the-Drunken-coder/n2-modular-hardpoint/project/analysis/improvements/README.md

# Improvement study runs

Summary: [docs/improvement-study.md](../../../docs/improvement-study.md). `results.csv` contains every case. `runs/<variant>/` contains `summary.json`, `geom.json` and the exact solver configs. These were generated by `tools/n2fea.py`. STEP and fields are not kept; rerun the tool to regenerate them.
