the-Drunken-coder/n2-modular-hardpoint/STATUS.md

# N2 status — R5

_Auto-generated by `site/build_status.py`; the selection is `project/active_design.json`._

**Current design:** R5, TowerPro MG92B positional servo, 3 printed parts in Bambu PAHT-CF. Receiver body: 72 × 53.5 × 20 mm. The complete retained envelope, including servo overhang, is specified in the [R5 package](project/designs/r5/README.md).

**Required loaded release:** 0.454 kg complete departing mass, 2 g total = **8.9044 N**. Complete-assembly retention proof target: **17.8089 N**. Extraction: -Z in R5 assembly coordinates.

**Evidence:** unqualified bench prototype. No assigned working-load rating, physical test result or flight qualification. Run the R5 CAD, mechanics, FEA and risk checks on this checkout; do not inherit old result numbers. See [evidence](docs/EVIDENCE_AND_READINESS.md).

**Next physical gate:** [R5 print inspection](docs/print-requirements.md), calibrated [servo interface](project/designs/r5/electronics/README.md), then the complete-assembly [R5 bench plan](docs/test-plan.md). Observe keeper clearance and actual departure separately.

P14 is a historical solenoid reference. Its committed STLs, controller tests and stress screens do not describe R5.

## Current sources

- [Requirements](docs/requirements.md)
- [R5 package and BOM](project/designs/r5/README.md)
- [CAD generator](project/designs/r5/cad/build.py)
- [Metadata](project/designs/r5/design.json)
