the-Drunken-coder/n2-modular-hardpoint/project/docs/review_notes.md

# P11 selection review record

## Decision implemented

N2 is the sole active development design. The CAD geometry and existing local controller function were preserved. The active documentation, BOM, print guidance, handoff and analysis subset now describe N2 alone.

## Review findings retained in the handoff

| Finding | Disposition |
|---|---|
| A selected design could be mistaken for a qualified or universally strongest attachment | Selection is recorded as the user's development choice. FEA numbers are raw model stress-threshold crossings, explicitly separate from proof/service load, breakage and loaded-release capacity. |
| Continuous rigid backing can overstate a real two-bolt installation's stiffness | The full-backing and ideal two-hole results remain distinct; aircraft backing and joints are open installation decisions. |
| The distal support exists in the CAD but has only 0.6 mm nominal retained overlap | Unloaded dimensional inspection and actual support engagement precede loaded tests. Ineffective-support results remain visible. |
| Support disappears before the adapter is unlocked | The 0.6 mm support-loss and 2.3 mm unlock positions are explicit. Full-stroke withdrawal demand and binding are priority measurements. |
| Historical manufacturing material notes could conflict with the user's PLA analysis choice | Active trial guidance and BOM use PLA, with the same 1.24 g/cm³ mass assumption as the analysis. Original CAD records remain frozen for provenance. |
| A nominal open position or animated departure could be mistaken for successful physical separation | The viewer's prescribed departure is illustrative. The design has no ejector or departure sensor; measured command, unlock and complete clearance are separate events. |
| Spring return or zero coil power could be mistaken for a fixed-pod lock | No positive fixed-use lock is claimed or added. Partial departure and spring recapture remain failure cases. |
| Reused controller tests could be mistaken for a powered N2 test | All 16 host logic tests and Python syntax checks were rerun and passed. Hardware execution, coil heating, loaded release and aircraft separation were not performed. |
| Old prices could be mistaken for a current quote or complete cost | Prices retain their 2026-10-26 source date, allowances and unpriced rows. The consumed mechanism subtotal and partial bench subtotal have explicit exclusions. |

## Changes made after this review

- Replaced active print guidance with a labeled PLA starting process and thin-wall/support inspection gates.
- Recomputed ideal part masses and material-cost arithmetic from the unchanged N2 CAD volumes using 1.24 g/cm³.
- Preserved the complete local COTS circuit, firmware and source records without functional change; recorded a fresh host-only test run.
- Added N2-specific assumptions, failure behavior, mounting decisions, inspection form and test priorities.

No additional physical or numerical strength claim was generated by this consolidation. Geometry improvement should follow the fit, force and mounting evidence listed in [verification.md](verification.md).
