the-Drunken-coder/n2-modular-hardpoint/project/analysis/figures/N2_convergence.png

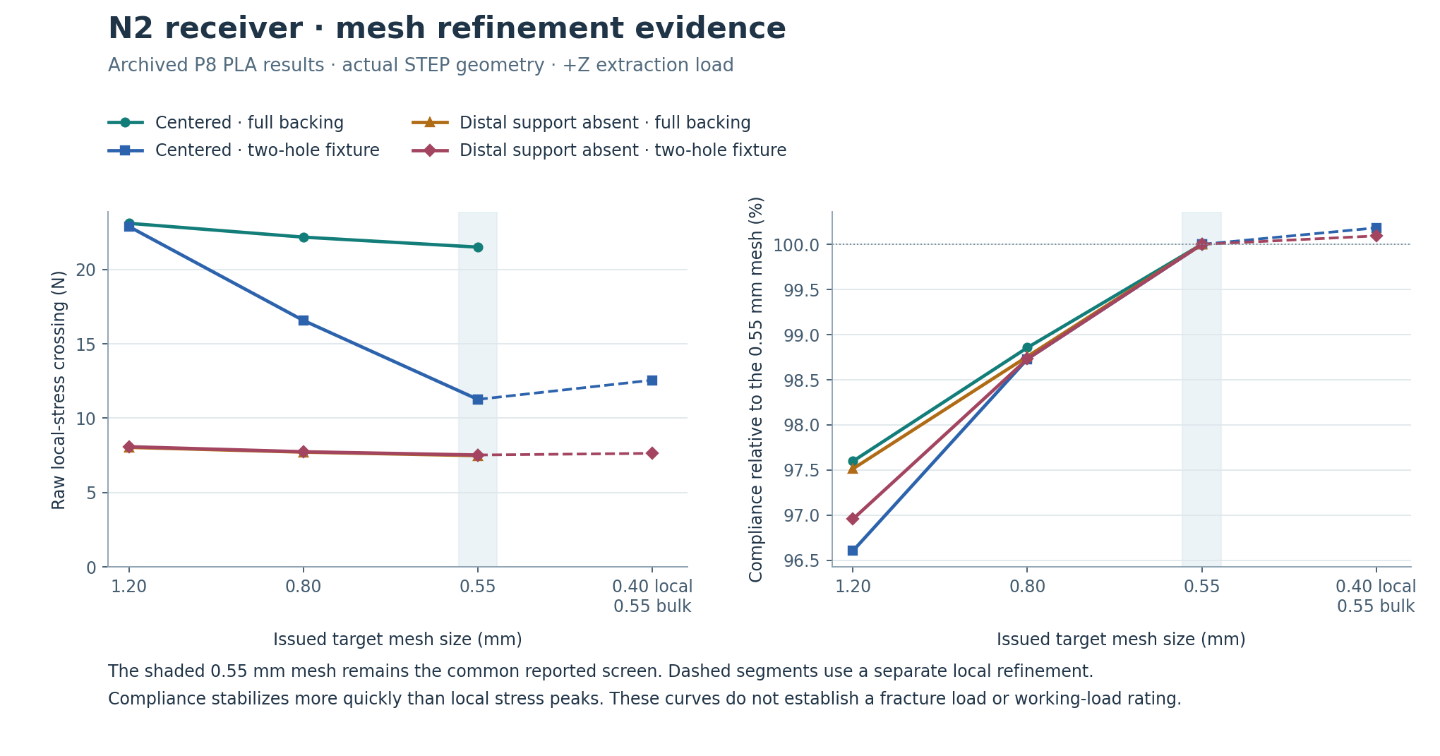
project/analysis/figures/N2_convergence.png
