the-Drunken-coder/n2-modular-hardpoint/project/drawings/N2_dimensions.png

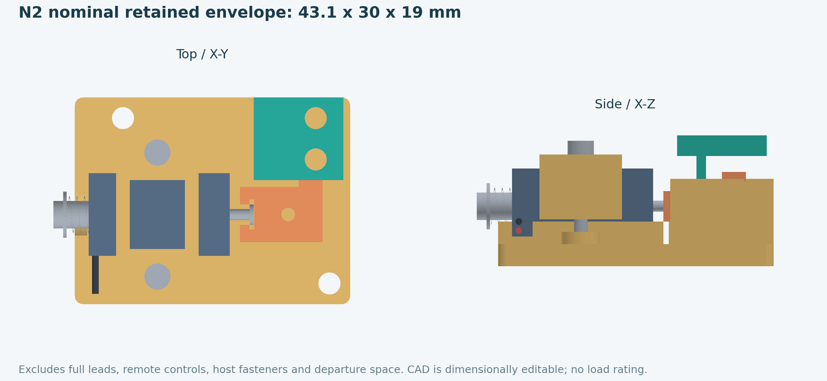
project/drawings/N2_dimensions.png
