the-Drunken-coder/n2-modular-hardpoint/project/drawings/N2_exploded.png

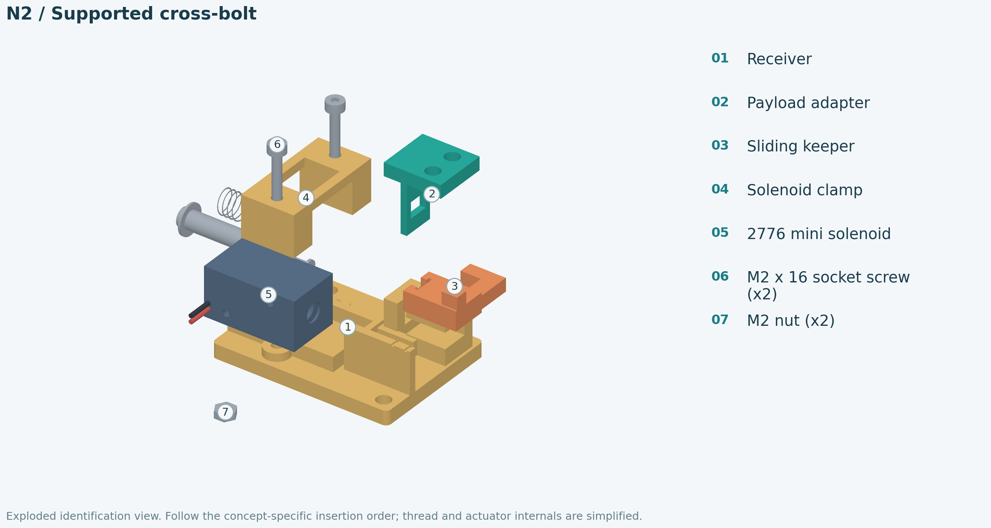
project/drawings/N2_exploded.png
