the-Drunken-coder/n2-modular-hardpoint/project/drawings/N2_separated.png

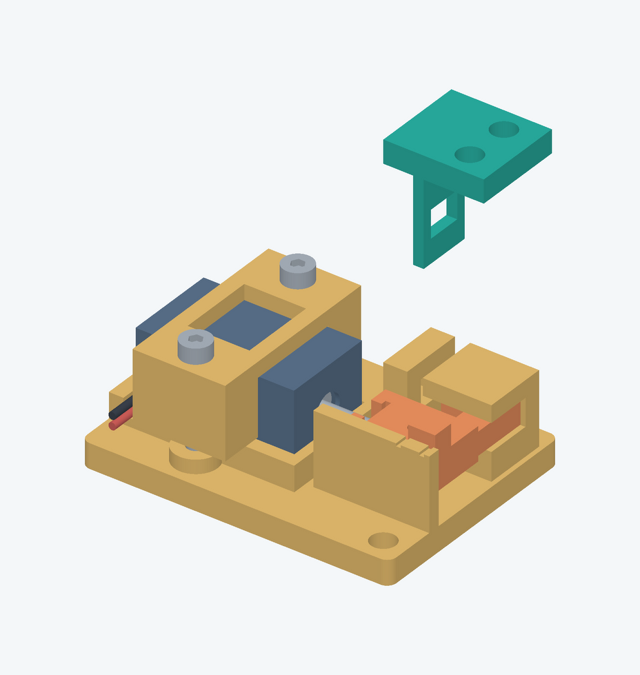
project/drawings/N2_separated.png
