the-Drunken-coder/n2-modular-hardpoint/project/drawings/N2_sequence.png

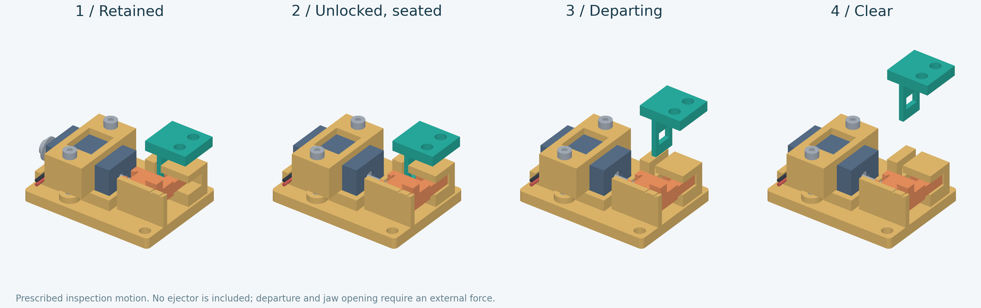
project/drawings/N2_sequence.png
