the-Drunken-coder/n2-modular-hardpoint/project/drawings/N2_unlocked.png

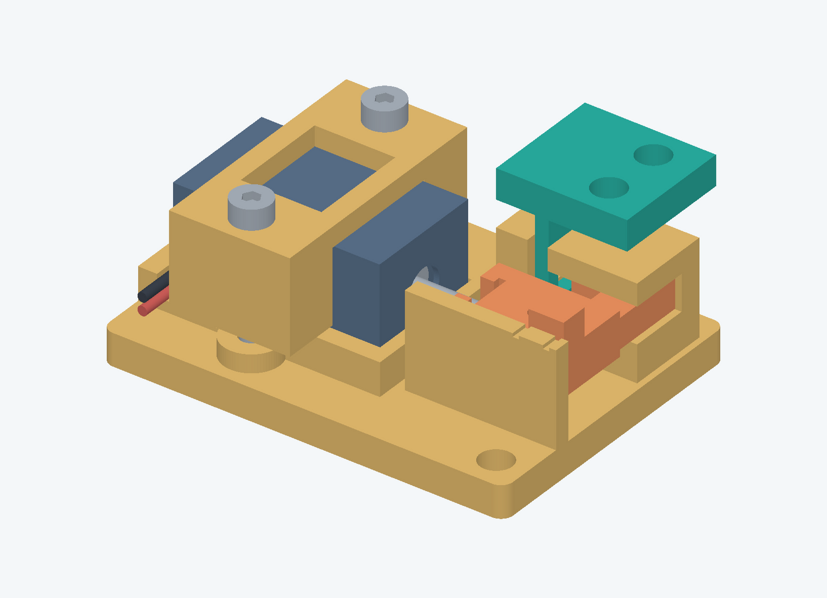
project/drawings/N2_unlocked.png
