the-Drunken-coder/n2-modular-hardpoint/project/cad/N2/assembly.step

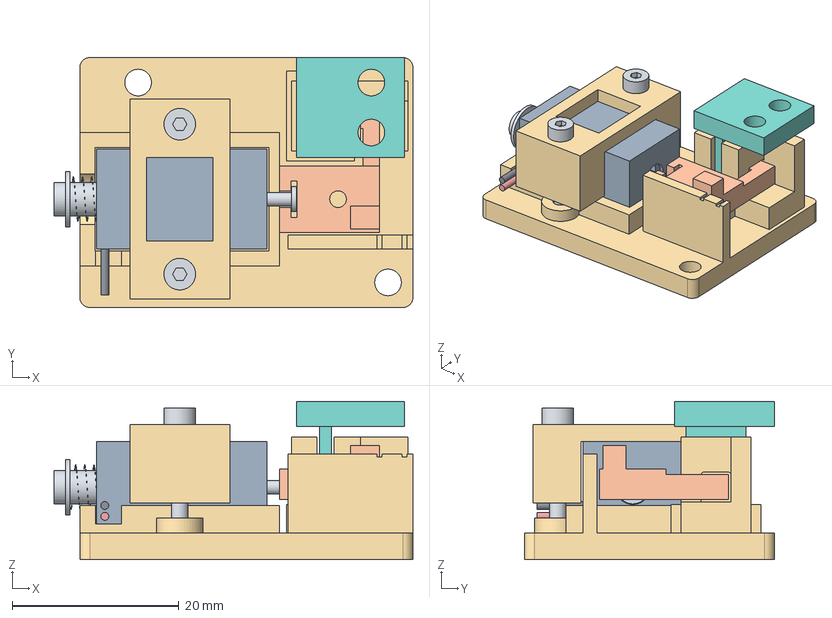
[picture p27: CAD file, 2026-10-29]
project/cad/N2/assembly.step
43.1 x 30.0 x 19.0 mm
N2_receiver
N2_adapter
N2_keeper
N2_clamp
N2_solenoid_body
N2_armature
N2_return_spring
N2_wire_1
N2_wire_2
N2_clamp_screw_1
N2_clamp_nut_1
N2_clamp_screw_2
N2_clamp_nut_2
