the-Drunken-coder/n2-modular-hardpoint/project/analysis/geometry/N2/N2_keeper.step

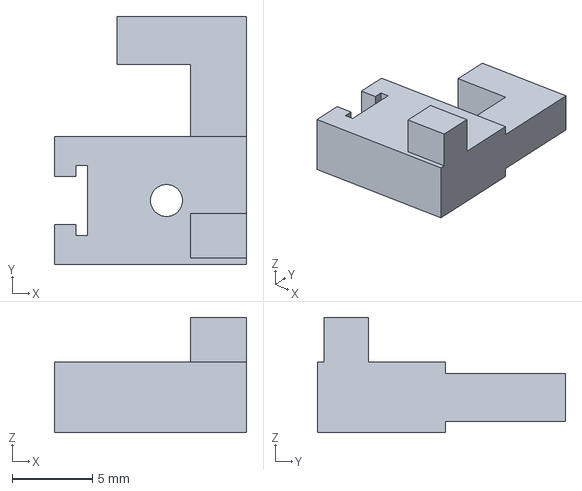
[picture p28: CAD file, 2026-10-29]
project/analysis/geometry/N2/N2_keeper.step
12.0 x 15.5 x 7.20 mm
