the-Drunken-coder/n2-modular-hardpoint/project/cad/N2/N2_wire_2.step

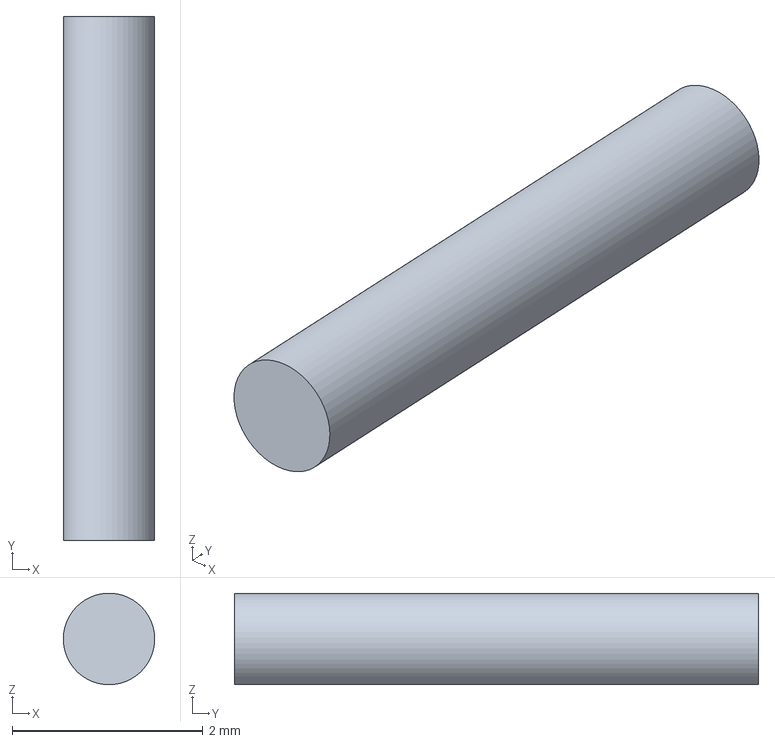
[picture p29: CAD file, 2026-10-29]
project/cad/N2/N2_wire_2.step
0.96 x 5.50 x 0.959 mm
