the-Drunken-coder/n2-modular-hardpoint/project/analysis/geometry/N2/N2_receiver.step

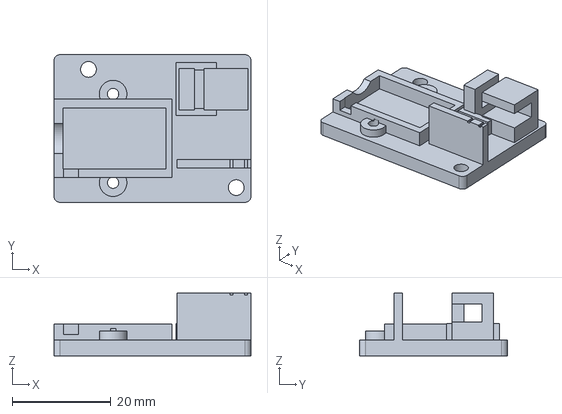
[picture p30: CAD file, 2026-10-29]
project/analysis/geometry/N2/N2_receiver.step
40.0 x 30.0 x 12.7 mm
