the-Drunken-coder/n2-modular-hardpoint/project/cad/N2/N2_solenoid_body.step

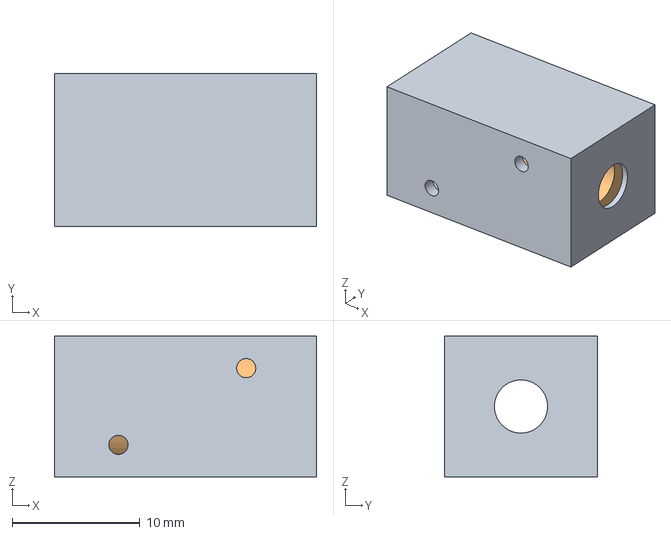
[picture p31: CAD file, 2026-10-29]
project/cad/N2/N2_solenoid_body.step
20.5 x 12.0 x 11.0 mm
