the-Drunken-coder/n2-modular-hardpoint/project/analysis/geometry/N2/N2_adapter.step

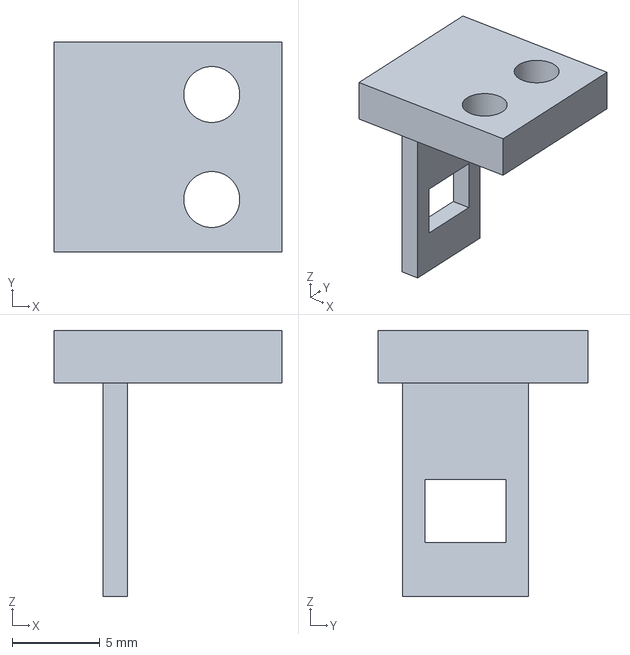
[picture p32: CAD file, 2026-10-29]
project/analysis/geometry/N2/N2_adapter.step
13.0 x 12.0 x 15.2 mm
