the-Drunken-coder/n2-modular-hardpoint/project/cad/N2/N2_keeper.step

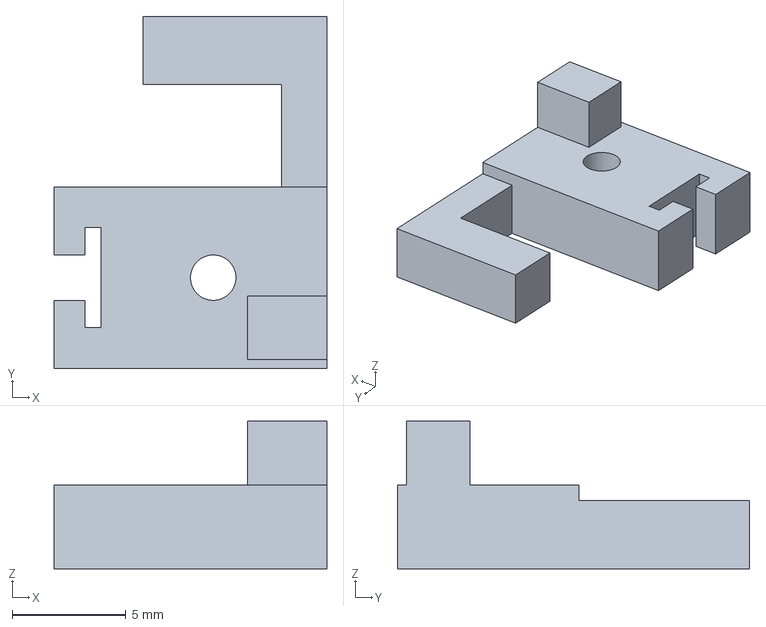
[picture p33: CAD file, 2026-10-29]
project/cad/N2/N2_keeper.step
12.0 x 15.5 x 6.50 mm
