the-Drunken-coder/n2-modular-hardpoint/project/cad/N2/N2_receiver.step

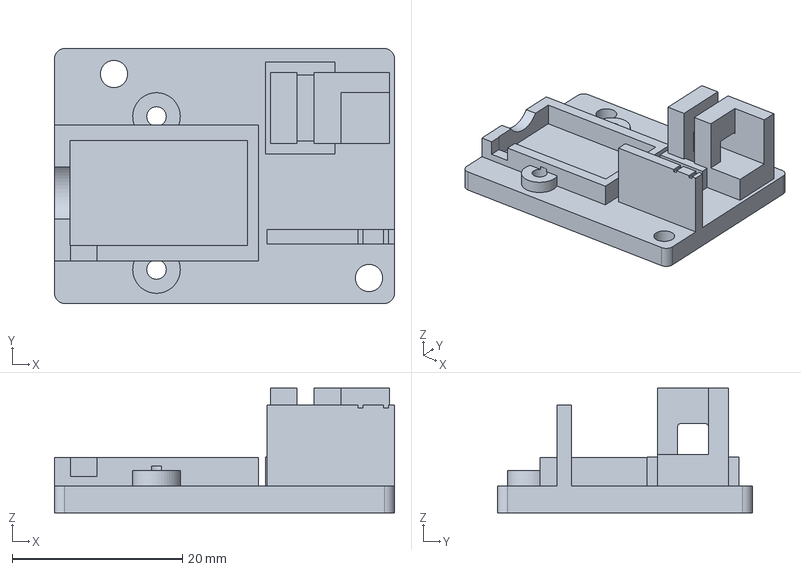
[picture p34: CAD file, 2026-10-29]
project/cad/N2/N2_receiver.step
40.0 x 30.0 x 14.7 mm
