the-Drunken-coder/n2-modular-hardpoint/project/cad/N2/N2_armature.step

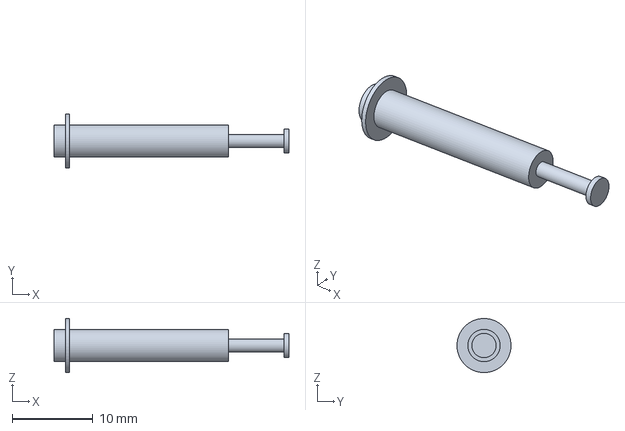
[picture p35: CAD file, 2026-10-29]
project/cad/N2/N2_armature.step
29.1 x 6.70 x 6.69 mm
