the-Drunken-coder/n2-modular-hardpoint/project/cad/N2/N2_clamp.step

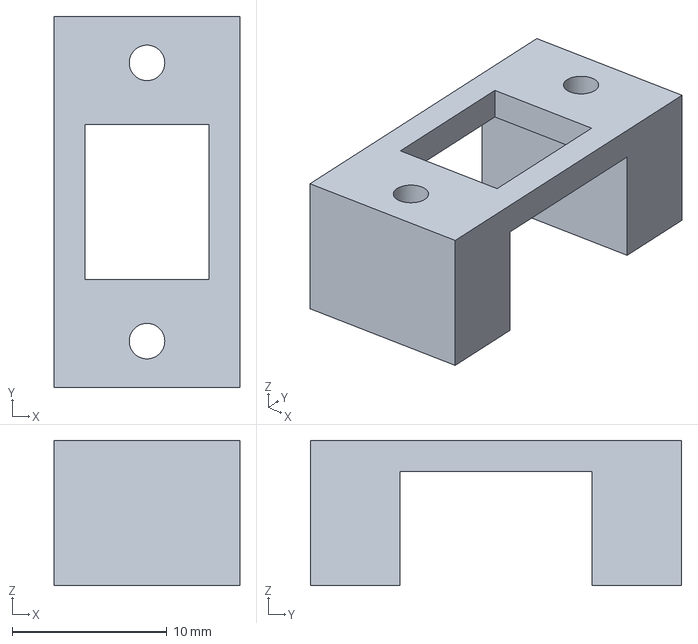
[picture p36: CAD file, 2026-10-29]
project/cad/N2/N2_clamp.step
12.0 x 24.0 x 9.40 mm
