the-Drunken-coder/n2-modular-hardpoint/project/cad/N2/N2_return_spring.step

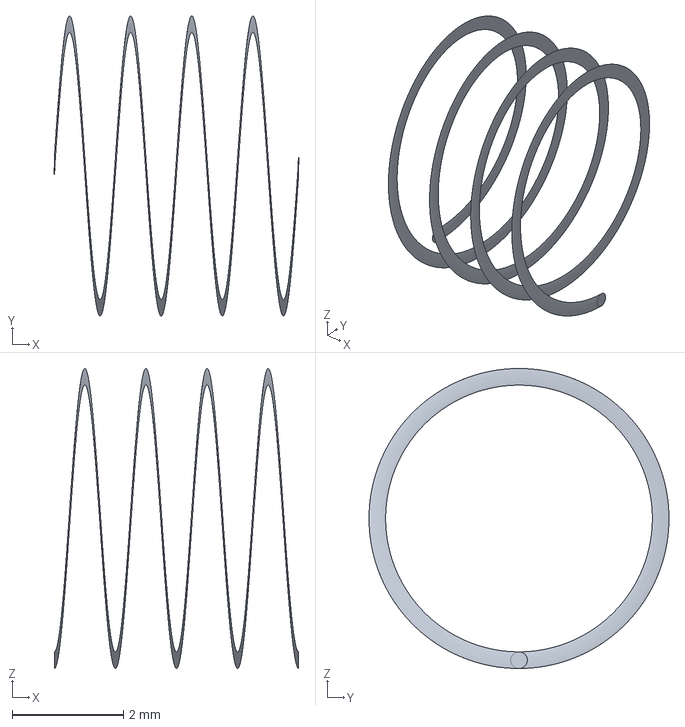
[picture p37: CAD file, 2026-10-29]
project/cad/N2/N2_return_spring.step
4.40 x 5.40 x 5.40 mm
