the-Drunken-coder/n2-modular-hardpoint/project/cad/N2/N2_clamp_screw_2.step

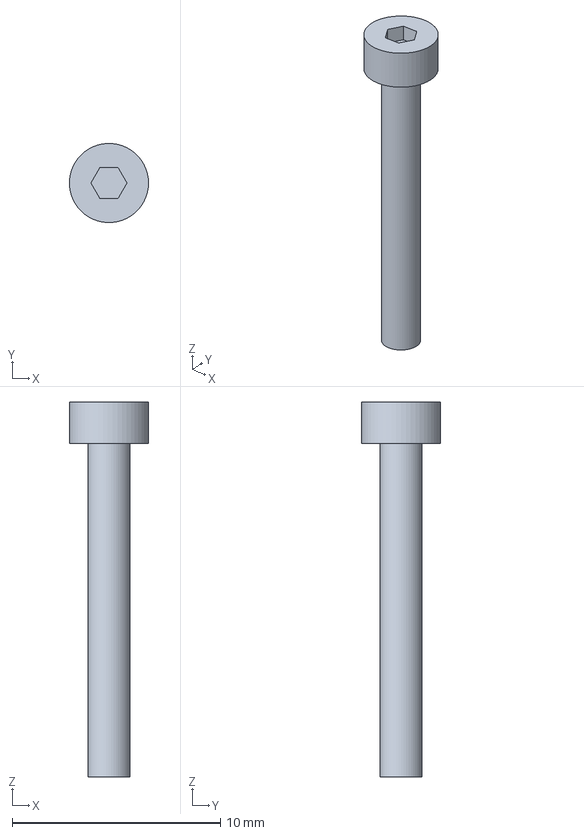
[picture p38: CAD file, 2026-10-29]
project/cad/N2/N2_clamp_screw_2.step
3.80 x 3.80 x 18.0 mm
