the-Drunken-coder/n2-modular-hardpoint/(list of files, cad)

Other CAD files:
project/cad/N2/N2_receiver_print.stl
project/cad/N2/N2_wire_1.step
project/cad/N2/N2_keeper_print.stl
project/cad/N2/N2_adapter.step
project/cad/N2/N2_clamp_print.stl
project/cad/N2/N2_adapter_print.stl
project/cad/N2/N2_adapter.stl
project/cad/N2/N2_armature.stl
project/cad/N2/N2_clamp.stl
project/cad/N2/N2_clamp_nut_1.step
project/cad/N2/N2_clamp_nut_1.stl
project/cad/N2/N2_clamp_nut_2.step
project/cad/N2/N2_clamp_nut_2.stl
project/cad/N2/N2_clamp_screw_1.step
project/cad/N2/N2_clamp_screw_1.stl
project/cad/N2/N2_clamp_screw_2.stl
project/cad/N2/N2_keeper.stl
project/cad/N2/N2_receiver.stl
project/cad/N2/N2_return_spring.stl
project/cad/N2/N2_solenoid_body.stl
project/cad/N2/N2_wire_1.stl
project/cad/N2/N2_wire_2.stl
