the-Drunken-coder/n2-modular-hardpoint/project/analysis/results.csv

result_path | id | variant | case | h_mm | elements | dofs | raw_strength_threshold_N | raw_peak_failure_index | raw_peak_tensile_MPa | raw_peak_compressive_MPa | raw_peak_max_shear_MPa | raw_peak_vm_MPa | max_displacement_mm | compliance_Nmm | strain_energy_Nmm | force_balance_error_N | moment_balance_error_Nmm | relative_free_residual | gauge_reaction_norm_N | relative_volume_error | step_sha256 | configuration_sha256 | driver_sha256
results/N2_adapter/h1.2/centered.json | N2_adapter | N2 | centered | 1.2 | 2910 | 16329 | 27.665783941045024 | 0.03614573156976035 | 0.9036432892440087 | 0.5974222834735461 | 0.37293410633311386 | 0.7188163314459642 | 0.0018180215171554335 | 0.0017075945849955123 | 0.0008537972924977833 | 3.116666919027811e-14 | 8.722634174373849e-13 | 4.102491574130892e-13 | 0.0 | 0.001145778882596149 | 06fb0220b7c0cb94ed453cca4de5fbe115497101730e6bcb82289e553e829944 | 51575036a639dd869b58bc233b727b1c043663feee167ce0a5396c01b51d97e0 | 6d71978731b6bf856921f1e1d2e5eb383682f4f9ba6bc65ebfdaede7187789b9
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
