the-Drunken-coder/n2-modular-hardpoint/project/analysis/improvements/results.csv

variant | part | case | dir | PLA_fail_N | PAHT-CF_fail_N | rating_SF2_N
V0_baseline | adapter | adapter | XZ45 | 3.76 | 5.7 | 2.85
V0_baseline | adapter | adapter | XZ90 | 2.8 | 4.25 | 2.12
V0_baseline | adapter | adapter | YZ45 | 4.87 | 7.39 | 3.7
V0_baseline | adapter | adapter | YZ90 | 4.07 | 6.18 | 3.09
V0_baseline | adapter | adapter | Z | 22.21 | 33.68 | 16.84
V0_baseline | receiver | centered | XZ45 | 23.11 | 35.04 | 17.52
V0_baseline | receiver | centered | XZ90 | 20.61 | 31.25 | 15.62
V0_baseline | receiver | centered | YZ45 | 23.44 | 35.54 | 17.77
V0_baseline | receiver | centered | YZ90 | 19.76 | 29.95 | 14.98
V0_baseline | receiver | centered | Z | 34.28 | 51.98 | 25.99
V0_baseline | receiver | distal_ineffective | Z | 11.94 | 18.1 | 9.05
V0_wall | adapter | adapter | XZ45 | 19.04 | 28.86 | 14.43
V0_wall | adapter | adapter | XZ90 | 14.1 | 21.38 | 10.69
V0_wall | adapter | adapter | YZ45 | 26.84 | 40.7 | 20.35
V0_wall | adapter | adapter | YZ90 | 27.64 | 41.9 | 20.95
V0_wall | adapter | adapter | Z | 24.06 | 36.48 | 18.24
V0_wall | receiver | centered | XZ45 | 23.11 | 35.04 | 17.52
V0_wall | receiver | centered | XZ90 | 20.61 | 31.25 | 15.62
V0_wall | receiver | centered | YZ45 | 23.44 | 35.54 | 17.77
V0_wall | receiver | centered | YZ90 | 19.76 | 29.95 | 14.98
V0_wall | receiver | centered | Z | 34.28 | 51.98 | 25.99
V0_wall | receiver | distal_ineffective | Z | 11.94 | 18.1 | 9.05
V1_lug2.4 | adapter | adapter | XZ45 | 9.31 | 14.12 | 7.06
V1_lug2.4 | adapter | adapter | XZ90 | 7.02 | 10.64 | 5.32
V1_lug2.4 | adapter | adapter | YZ45 | 8.97 | 13.59 | 6.8
V1_lug2.4 | adapter | adapter | YZ90 | 7.15 | 10.84 | 5.42
V1_lug2.4 | adapter | adapter | Z | 41.33 | 62.66 | 31.33
V1_lug2.4 | receiver | centered | XZ45 | 28.49 | 43.19 | 21.59
V1_lug2.4 | receiver | centered | XZ90 | 26.06 | 39.52 | 19.76
V1_lug2.4 | receiver | centered | YZ45 | 21.89 | 33.19 | 16.6
V1_lug2.4 | receiver | centered | YZ90 | 22.87 | 34.67 | 17.34
V1_lug2.4 | receiver | centered | Z | 29.85 | 45.25 | 22.63
V1_lug2.4 | receiver | distal_ineffective | Z | 10.54 | 15.98 | 7.99
V2_lug3.4 | adapter | adapter | XZ45 | 15.16 | 22.98 | 11.49
V2_lug3.4 | adapter | adapter | XZ90 | 11.69 | 17.72 | 8.86
V2_lug3.4 | adapter | adapter | YZ45 | 13.9 | 21.08 | 10.54
V2_lug3.4 | adapter | adapter | YZ90 | 10.79 | 16.36 | 8.18
V2_lug3.4 | adapter | adapter | Z | 58.41 | 88.55 | 44.28
V2_lug3.4 | receiver | centered | XZ45 | 31.2 | 47.3 | 23.65
V2_lug3.4 | receiver | centered | XZ90 | 27.58 | 41.81 | 20.91
V2_lug3.4 | receiver | centered | YZ45 | 20.5 | 31.08 | 15.54
V2_lug3.4 | receiver | centered | YZ90 | 21.28 | 32.27 | 16.14
V2_lug3.4 | receiver | centered | Z | 27.74 | 42.06 | 21.03
V2_lug3.4 | receiver | distal_ineffective | Z | 8.83 | 13.39 | 6.69
V2_lug3.4_wall | adapter | adapter | XZ45 | 34.94 | 52.97 | 26.49
V2_lug3.4_wall | adapter | adapter | XZ90 | 28.62 | 43.39 | 21.7
V2_lug3.4_wall | adapter | adapter | YZ45 | 70.88 | 107.46 | 53.73
V2_lug3.4_wall | adapter | adapter | YZ90 | 66.67 | 101.07 | 50.54
V2_lug3.4_wall | adapter | adapter | Z | 60.73 | 92.08 | 46.04
V2_lug3.4_wall | receiver | centered | XZ45 | 31.2 | 47.3 | 23.65
V2_lug3.4_wall | receiver | centered | XZ90 | 27.58 | 41.81 | 20.91
V2_lug3.4_wall | receiver | centered | YZ45 | 20.5 | 31.08 | 15.54
V2_lug3.4_wall | receiver | centered | YZ90 | 21.28 | 32.27 | 16.14
V2_lug3.4_wall | receiver | centered | Z | 27.74 | 42.06 | 21.03
V2_lug3.4_wall | receiver | distal_ineffective | Z | 8.83 | 13.39 | 6.69
