the-Drunken-coder/n2-modular-hardpoint/project/analysis/p13_expanded/results.csv

component | case | raw_failure_N | rating_SF3_N | margin_vs_4N | r04_N | r08_N | peak_xyz | h_mm | dofs | force_err | gauge
N2_adapter | low_y_half_contact__XZ+90 | 2.5535219580501836 | 0.8511739860167279 | 0.6383804895125459 | 7.091260711244531 | 12.079697096720498 | [27.94, 7.64, 10.36] | 0.55 | 44742 | 1.1160419206254243e-11 | 0.0
N2_adapter | low_y_half_contact__XZ-90 | 2.7876144766793756 | 0.9292048255597919 | 0.6969036191698439 | 7.274835754112902 | 12.319278367039637 | [27.08, 7.63, 10.32] | 0.55 | 44742 | 1.1911180463658654e-11 | 0.0
N2_adapter | centered__XZ+90 | 2.8859175782169966 | 0.9619725260723322 | 0.7214793945542491 | 7.650086710095548 | 12.71299224291092 | [27.94, 7.64, 10.36] | 0.55 | 44742 | 1.3156124299733404e-11 | 0.0
N2_adapter | distal_ineffective__XZ+90 | 2.8859175782169966 | 0.9619725260723322 | 0.7214793945542491 | 7.650086710095548 | 12.71299224291092 | [27.94, 7.64, 10.36] | 0.55 | 44742 | 1.3156124299733404e-11 | 0.0
N2_adapter | centered__XZ-90 | 3.0084857325714434 | 1.0028285775238144 | 0.7521214331428608 | 7.819808615641365 | 12.81931466719966 | [27.07, 12.36, 10.35] | 0.55 | 44742 | 1.280171720488575e-11 | 0.0
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
