the-Drunken-coder/n2-modular-hardpoint/project/analysis/validation_20261029/fea/results_summary.csv

study | part | case | mesh_target_mm | elements | dofs | PLA_assumed_stress_screen_N | PAHT_tensile_ratio_only_sensitivity_N | maximum_displacement_mm_per_N | peak_tensile_MPa_per_N | peak_compressive_MPa_per_N | peak_max_shear_MPa_per_N | relative_free_residual | force_balance_error_N | moment_balance_error_Nmm | gauge_reaction_norm_N | relative_mesh_volume_error | result_file | result_sha256 | step_sha256 | configuration_sha256 | driver_sha256
baseline | adapter | adapter__Z | 0.55 | 8492 | 44730 | 22.213440234880597 | 33.67844164643187 | 0.0018278257611261351 | 1.1254447638751524 | 0.5657031105243251 | 0.4927152808270173 | 7.860985954804852e-10 | 1.1048838622686824e-11 | 2.6328339955368073e-10 | 0.0 | 0.001145778882596149 | configs/results/N2_adapter_baseline/h0.55/adapter__Z.json | 6eb2422989d970efb113cf93a89e86296e104b82e7bffec5391b81d6aae8c8a3 | fac0ae34b99824b56b1a253ca65d3f81ba6475433464a432675456c617904d27 | 82139dcbf9c124d1c1318243765af27195e60ff61bb0c4a172bfa89570df1df0 | 6d9b172de0fca72755d74c663b9eba88c9d2bce19719962deb9385a2e644a64c
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
