the-Drunken-coder/n2-modular-hardpoint/CHANGELOG.md

# Changelog

## R5 active package — 2026-10-31

- Select the merged R5 servo design through explicit repository metadata.
- Route requirements, printing, controls, status and bench acceptance to R5.
- Preserve P14 as a historical reference; its green regressions do not qualify R5.

## P14 documentation and metadata correction — 2026-10-29

- Made P14 and candidate Bambu PAHT-CF consistent across current instructions, project/CAD metadata, catalog, viewer and generated status. Requirements remain 0.454 kg (1 lb, including departing adapter/hardware), 2 g and SF 2: 8.9 N design and 17.8 N sacrificial qualification targets.
- Corrected analysis language: 33.68 N is a PLA-threshold screen scaled by 47/31, and 16.84 N is division by SF 2. Neither is a measured failure load or working-load rating. Ideal full receiver backing, prescribed contact and unresolved P14 convergence/partial engagement are explicit.
- Replaced the superseded P13/9.1 N test procedure with P14 identification, host-mount records, fit/clearance gates, a staged 17.8 N sacrificial test and separately recorded unlock/clearance outcomes. Corrected P14 print orientations and marked slicing, material and hardware validation open.
- Fixed generators so current metadata drives exports/status; nondefault geometry studies do not inherit P14 strength/print claims. Added a consistency check and PR build verification.
- Labeled original P11 drawings, masses, manifests and imported-byte checks as historical. Guarded the historical PLA BOM generator against P14 input.
- No mechanical geometry, STEP/STL file, archived numerical result or controller behavior was changed; no CAD or FEA solve or physical test was performed for these corrections.

**History below:** records the conclusions and terminology used at each earlier step. Superseded “rating”, “PASS”, support-free and partial-engagement claims below are corrected by the current P14 documentation above.

## P14 — 2026-10-29
- **Proximal roof bridged** on both sides of the keeper channel (to X 31.7); keeper link moved past it; keeper underside flat at Z 7.2; stem slot ±1.0 so the armature button bears. Lug 1.4 / overlap 0.6 / 3 mm stroke unchanged.
- PAHT-CF straight pull, worst credible engagement (distal lost): **33.68 N, adapter governs** (receiver 36.73 N, keeper ≥ 57.4 N). 1.89× the 17.8 N requirement; rating 16.8 N at SF 2 (was 9.1 N). Losing the distal overlap no longer reduces capacity (R5d).
- **No supports** on any printed part in the supplied orientations (`tools/overhang.py`, new). Receiver base to bed, keeper flat, adapter flange down, clamp top down.
- R5c back-drive passes on analysis; R5e needs return-spring preload ≥ 0.26 N (measure it). See [docs/p14.md](docs/p14.md).

## Requirements: R1 → 1 lb — 2026-10-29
- R1 changed to 0.454 kg (1 lb, provisional). Design load 8.9 N, SF 2 minimum failure 17.8 N, proof test 17.8 N. P13 PAHT-CF (18.33 N, distal-lost governing case) now passes R4 marginally (+3%, inside mesh scatter); the proof test decides.

## Requirements — 2026-10-29
- Added [docs/requirements.md](docs/requirements.md): R1–R7 (1.81 kg, 2 g, straight pull, SF 2 → ≥ 71.2 N, fail-safe latch, one moving part, simple to print). P13 compliance: fails R4 (18.3 N), R5d (fragile distal state) and R7 (supports); R5c and R5e unknown.

## Improvement study — 2026-10-29
- Added [docs/improvement-study.md](docs/improvement-study.md): first-principles breakdown and 10 ideas, FEA or hand-calc each. Best: socket-wall bearing (90° 2.1 → 10.7 N) and a longer-stroke keeper with 3.4 mm lug and 2 mm overlap (≈21 N straight, ≥15.5 N any angle, PAHT-CF SF 2). Paper only; the current rating is unchanged.
- Added `tools/n2fea.py` (one-command variant build + FEA + rating) and `tools/n2variant.py`. Data in `project/analysis/improvements/`.

## Safety factor 2 — 2026-10-29
- **Safety factor changed from 3 to 2 (Lane's choice).** PAHT-CF rating **9.1 N** (≈ 0.92 kg at 1 g; 18.33 N / 2, rounded down), straight +Z only, untested. Off-axis at SF 2: 2.5 N at 45°, 1.9 N at 90°. PLA Basic baseline at SF 2: 6.0 N straight, 1.7 N at 45°, 1.2 N at 90°.
- SF 2 depends on the Z coupon test confirming TDS Z strength (47 MPa PAHT-CF); coupon test is now required.
- Test plan re-stepped to 4.5 / 9.1 / 13.6 / 18.2 N. Top step (18.2 N) sits at the predicted failure (18.3 N): spare parts only.

## Print requirements — 2026-10-29
- Material study: recommended Bambu PAHT-CF (TDS Z tensile 47 MPa vs PLA 31) with receiver on its −X end and adapter on its −Y side. **Provisional rating 6.1 N in PAHT-CF** (4.0 N in PLA Basic), straight pull, SF 3, untested. See docs/print-requirements.md.
- Added [docs/print-requirements.md](docs/print-requirements.md): dried PLA Basic, 100% solid, supplied orientations. The rating assumes these. Receiver roof and adapter floor tension crosses the layers (open issue). Test plan now requires a print record and has an optional Z coupon test.

## P13 expanded sims — 2026-10-29
- Re-ran all 12 archived cases on P13 geometry (receiver, adapter, keeper). Governing case unchanged: receiver distal_ineffective, **12.09 N → 4.0 N rating holds** for straight pull.
- Off-axis 15/30/45/90° in XZ and YZ: **adapter floor governs off-axis** (pessimistic model: 8.0 / 4.6 / 3.4 / 2.6 N failure). Rating not valid for angled/side loads.
- Interlayer strength at 50%: governing case 7.37 N (2.5 N rated).
- Mesh check 11.94–12.31 N. Results in `project/analysis/p13_expanded/`, write-up in `docs/p13-expanded-sims.md`.

## P13 — 2026-10-29
- **0.3 mm fillet** at the inside corners where the keeper-channel walls meet the roof underside (the governing stress spot). `build_n2.py` parameter `ROOF_FILLET` (env `N2_ROOF_FILLET`).
- Governing FEA screen (distal roof lost, 0.55 mm mesh): 10.30 N → **12.09 N**. Two-screw case 12.21 N, both roofs loaded 34.71 N.
- Mesh check at local 0.4 mm: 12.17 N (+0.6%), so the fillet result is mesh-stable.
- **Provisional rating 3.4 N → 4.0 N** (≈ 400 g at 1 g, SF 3). Untested.
- Fillets over 0.3 mm cut into the archived load patch and can't be screened like-for-like; 1.0 mm leaves 0.01 mm keeper clearance and ≥ 1.2 mm hits the keeper.
- Keeper clearance and release unchanged (0.3 mm open gap, no overlap).
- Regenerated receiver STEP/STL/print STL, assembly STEP, viewer data.
- `STATUS.md` in the repo root, regenerated on every push.
- GitHub Pages site rebuilt with Blueprint (dark): viewer for every CAD revision in git history (P11 import, P12, P13), compare mode (side by side with synced cameras, overlay, added/removed-material diff), rating/parameter/changelog deltas, status and docs. Built in the Pages workflow (`site/build_data.py` + `web/`).

## P12 — 2026-10-29
- **Receiver guide roofs raised +2.0 mm** (top Z 12.7 → 14.7). Only the receiver changed; keeper overlap stays 0.6 mm.
- Governing FEA screen (receiver, distal roof lost, 0.55 mm mesh): 7.48 N → **10.30 N**.
- **Provisional rating 2.4 N → 3.4 N** (≈ 340 g at 1 g, SF 3). Untested.
- `build_n2.py` now has `DISTAL_OVERLAP` and `ROOF_EXTRA` parameters (env `N2_DISTAL_OVERLAP`, `N2_ROOF_EXTRA`).
- Regenerated receiver STEP/STL/print STL, assembly STEP, viewer data.
- Sweep results: `project/analysis/p12_roof_sweep/`. Test plan load steps updated.

## P11 review — 2026-10-29
- FEA review of the 39 archived cases, first provisional rating (2.4 N), proof-test plan.
