the-Drunken-coder/n2-modular-hardpoint/(commit log)

2026-10-29 import: preserve N2 design sources and engineering evidence
    [N2_adapter.step, N2_adapter.stl, N2_adapter_print.stl, N2_armature.step, N2_armature.stl, N2_clamp.step, N2_clamp.stl, N2_clamp_nut_1.step]
2026-10-29 P12: raise receiver roofs +2.0 mm, rating 3.4 N provisional; add Pages status site
    [N2_receiver.step, N2_receiver.stl, N2_receiver_print.stl, assembly.step]
2026-10-29 P13: 0.3 mm roof inside-corner fillet, rating 4.0 N; replace Pages with STATUS.md
    [N2_receiver.step, N2_receiver.stl, N2_receiver_print.stl, assembly.step]
2026-10-29 Restore Pages site with P13 3D assembly viewer and part toggles
2026-10-29 analysis: P13 expanded sims (re-run all cases, off-axis sweep, interlayer check, mesh check)
    [results.csv]
2026-10-29 docs: print requirements, print record + Z coupon test
2026-10-29 Material study: PAHT-CF recommendation, reorient receiver/adapter, 6.1 N provisional rating
2026-10-29 Improvement study: first-principles breakdown, 10 ideas tested, tools/n2fea.py one-command variant FEA
    [results.csv]
2026-10-29 P14: bridged proximal roof, flat keeper, support-free prints
    Distal-lost receiver 36.73 N > adapter 33.68 N (PAHT-CF), so losing the
    0.6 mm overlap no longer reduces capacity. Zero support area on all printed
    parts (tools/overhang.py). R5c/R5e analysis in docs/p14.md.
    [N2_adapter.step, N2_armature.step, N2_clamp.step, N2_clamp_nut_1.step, N2_clamp_nut_2.step, N2_clamp_screw_1.step, N2_clamp_screw_2.step, N2_keeper.step]
2026-10-29 docs: remove printer-specific references
2026-10-30 Record P14 mounting and withdrawal validation with concept verification protocols
    [actuator_force_curve.csv, current_p14_clearance_checks.csv, durability_environment.csv, extra_normal_load_force_trade.csv, illustrative_force_sweep.csv, illustrative_tolerance_sweep.csv, instrumentation.csv, interface_fit.csv]
2026-10-30 Run fresh FEA, CAD clearance and controller validation in GitHub Actions
    Require complete current-checkout evidence, audit numerical consistency, and retain per-job results without overwriting the historical study.
    [current_p14_clearance_checks.csv, extra_normal_load_force_trade.csv, illustrative_force_sweep.csv, illustrative_tolerance_sweep.csv, results_summary.csv, stroke_comparison.csv, stroke_overlap_series.csv]
2026-10-30 Record pod envelope, 2 g release and fixed 5 V design inputs
    Separate user requirements from rounded packaging, mass and current-budget assumptions. Close the earlier decision questions, keep P14 qualification open in light of the mounting/overlap study, and direct current-checkout replay to the CI wrappers. Issued CAD, firmware and FEA models are unchanged.
2026-10-31 R5 clean: simplified servo hardpoint (#13)
    * R5 clean: 3-part servo hardpoint, no captive nuts, CI-generated CAD/FEA
    * r5: address review, converged FEA, risk simulations
    * R5 viewer: full assembly, servo-crank release kinematics, FEA colormap
    * R5: horn centre screw with keeper groove + sweep clearance check; FEA view peak focus, auto colour scale, peak label
    * R5: compact body (64x48.5x18, 19.1 g) and purchased-parts BOM with links/specs
    ---------
    [bom.csv]
2026-10-31 fix(r5): clear complete servo gland and provide continuous lead route (#16)
2026-10-31 Fix R5 lower-tab jam strength and allowable mismatch (#17)
    * fix(r5): clear complete servo gland and provide continuous lead route
    * fix(r5): reinforce lower tab root against the declared jam allowable
    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
2026-10-31 Fix loaded keeper roof and horn clearance across inspected guide poses (#19)
    * fix(r5): define 5 V interface and calibrated servo bench controls
    * fix(r5): preserve loaded keeper clearance across inspected guide poses
    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
    [bench_config.py, bench_core.py, calibrate.py, main.py]
2026-10-31 Fix R5 tolerance bounds, pin-slot lost motion and reliability claims (#20)
    * fix(r5): verify inspected fit bounds including pin-slot play
    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
    [bench_config.py, bench_core.py]
2026-10-31 Retain the crank pin and verify the complete mechanism and mounting geometry (#22)
    * fix(r5): apply and audit the full structural proof load
    * fix(r5): retain crank pin, bound coupled travel and preserve mounting bosses
    * docs(r5): synchronize the overview release endpoint limit
    ---------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
    [bom.csv]
2026-10-31 Define and verify R5 print orientation, process and inspection evidence (#23)
    * fix(r5): export oriented print parts and define a traceable first-ar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
    [bom.csv, inspection-template.csv]
2026-10-31 Select R5 consistently across requirements, status, documentation and viewer (#25)
    * fix(r5): export oriented print parts and define a traceable fir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
    [bom.csv, inspection-template.csv]
2026-10-31 Define complete-assembly proof, repeated loaded release and installation limits (#26)
    * fix(r5): export oriented print parts and define a traceable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
    [faults.csv, installation.csv, releases.csv, retention.csv, specimens.csv]
2026-10-31 Fail preview publication on missing, stale or failed active-design evidence (#27)
    * fix(r5): export oriented print parts and define a traceable firs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
2026-10-31 Fix R5 servo voltage assumptions and add calibrated bench controls (#18)
    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
2026-10-31 Fix the tenfold FEA underload and audit force, moment and reactions (#21)
    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
2026-10-31 Fix coupled release mechanics and require converged, traceable R5 evidence (#24)
    * fix(r5): export oriented print parts and define a traceable first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
2026-10-31 Remove the wing base plate from the R5 viewer model (#29)
    * Remove the wing base plate from the R5 viewer model
    * Drop the ghost-wing host opening test with the plate
    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
